UwaisBaig/AERIS-Monitor/docs/AERIS-Circuit.png

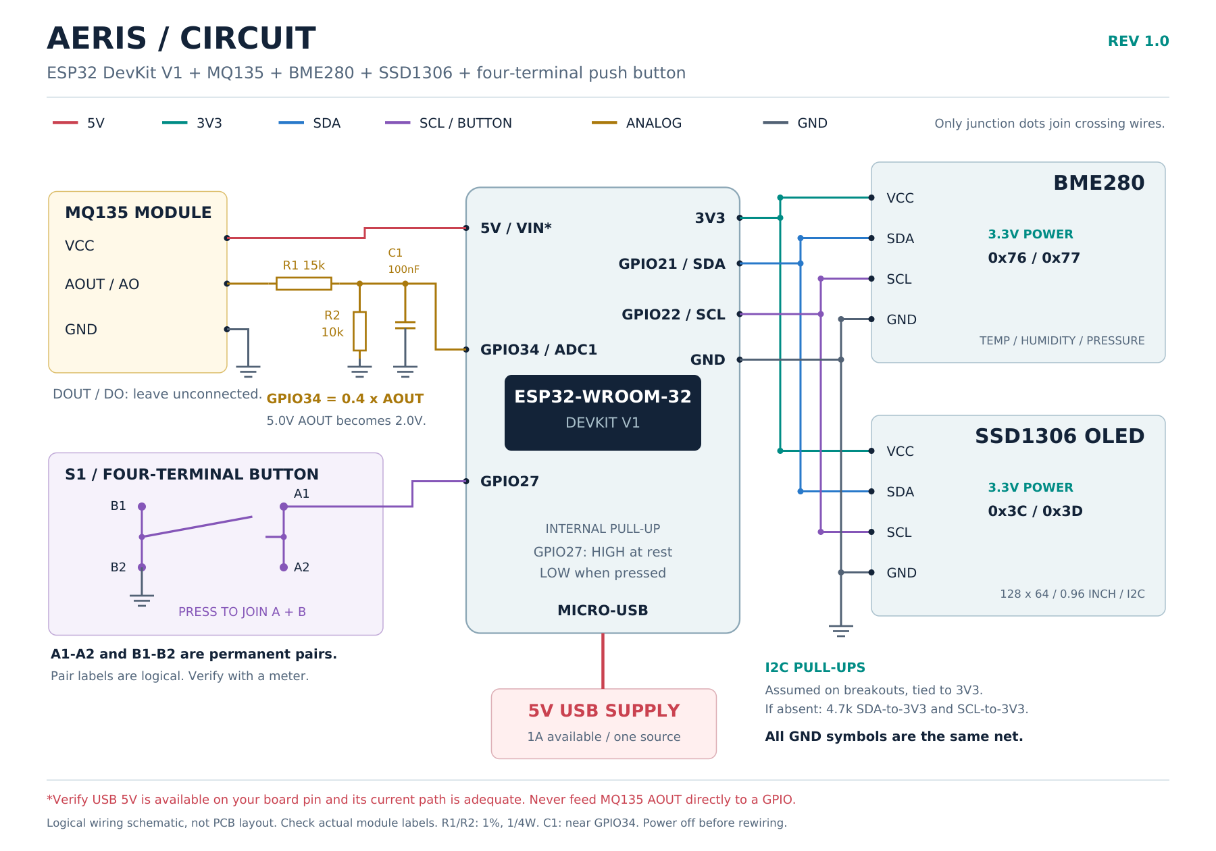
docs/AERIS-Circuit.png
