UwaisBaig/AERIS-Monitor/docs/AERIS-Dance-Preview.png

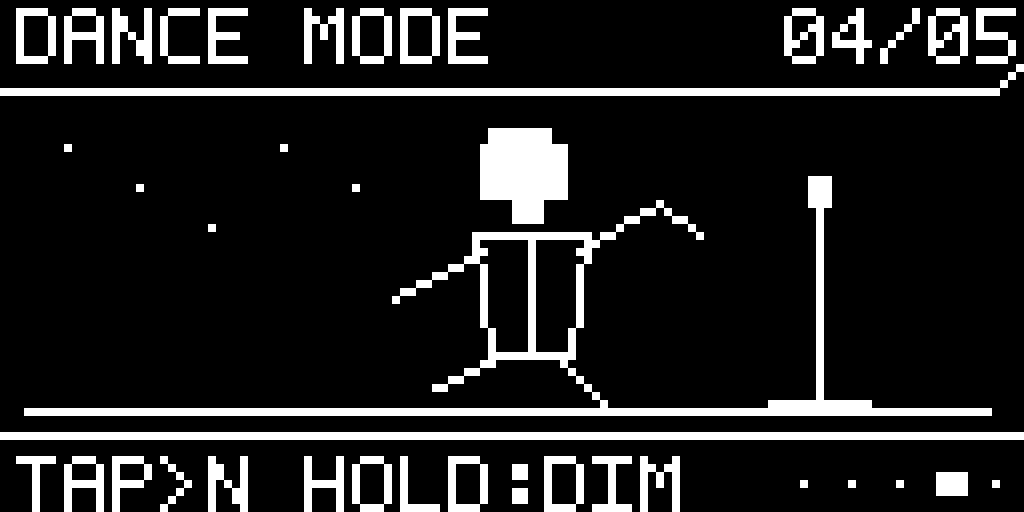
docs/AERIS-Dance-Preview.png
