UwaisBaig/AERIS-Monitor/docs/AERIS-Display-Preview.png

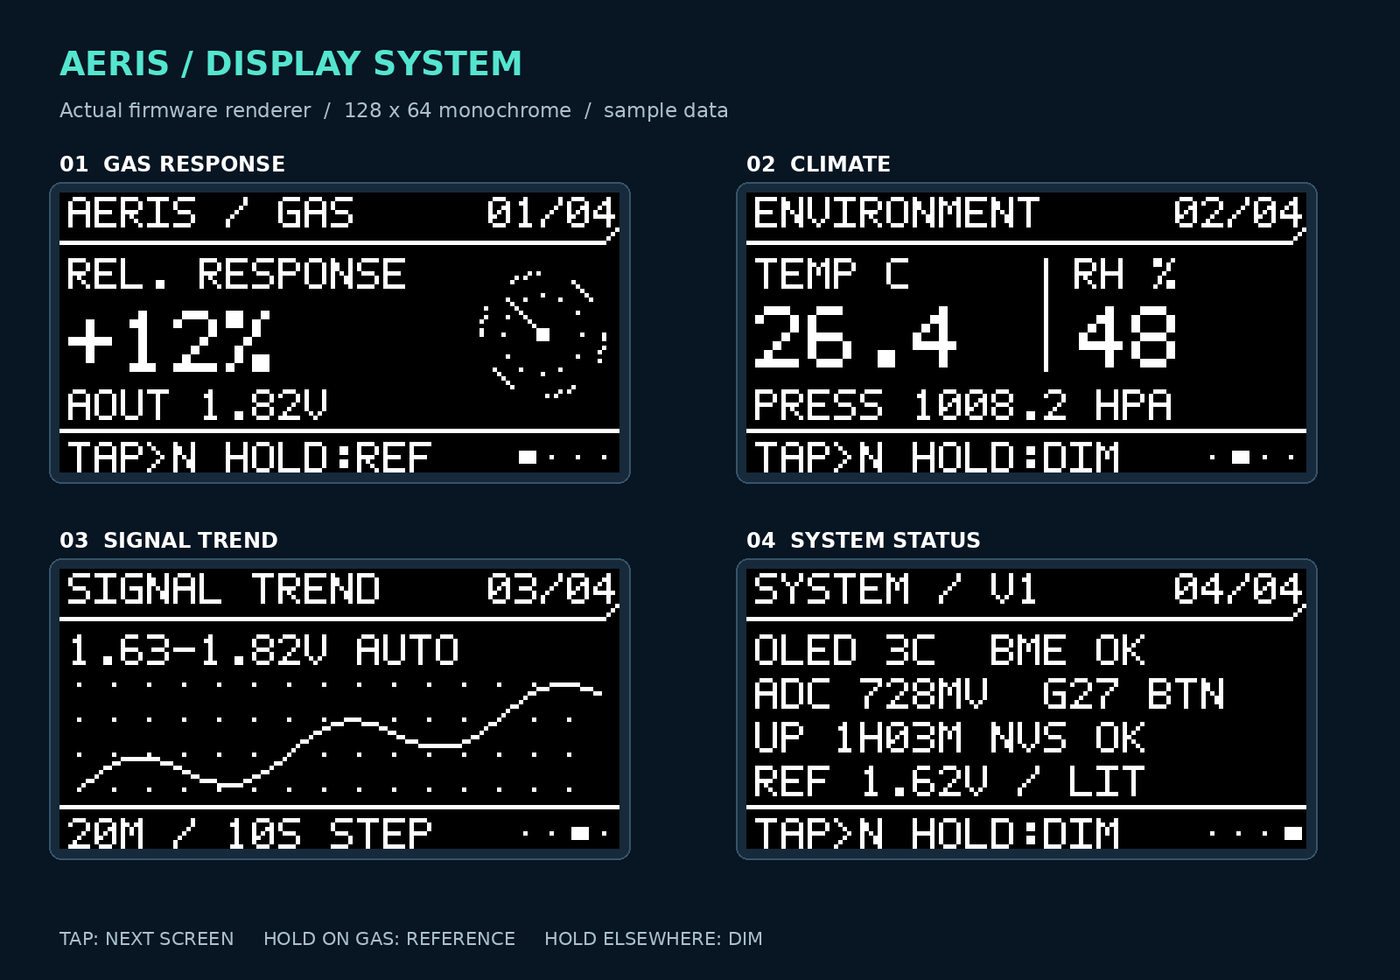
docs/AERIS-Display-Preview.png
