UwaisBaig/AERIS-Monitor/docs/screen-1.png

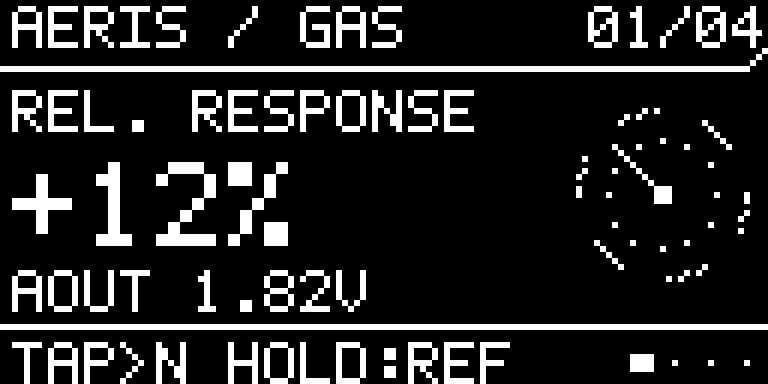
docs/screen-1.png
