UwaisBaig/AERIS-Monitor/docs/screen-2.png

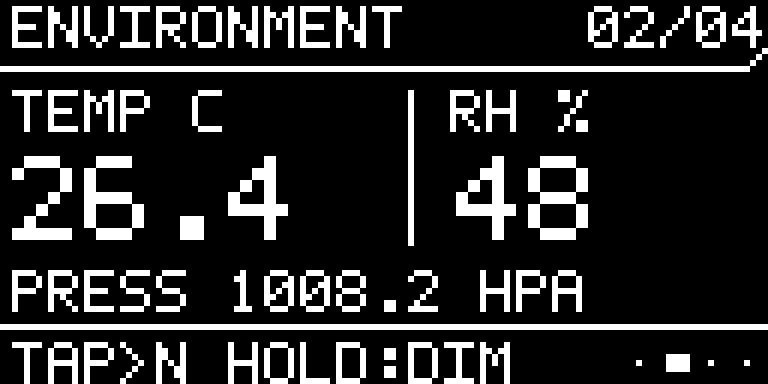
docs/screen-2.png
