UwaisBaig/AERIS-Monitor/docs/screen-3.png

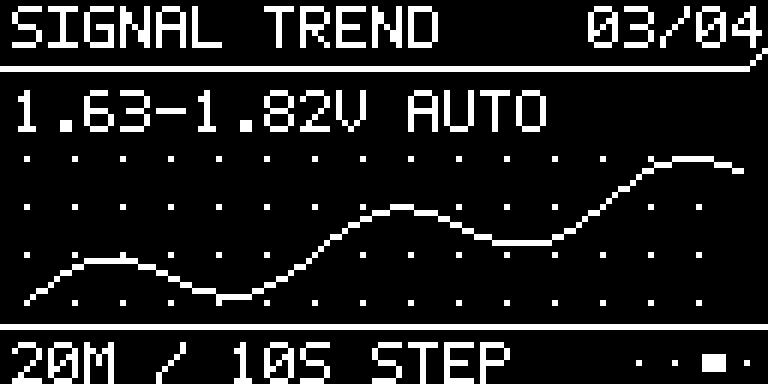
docs/screen-3.png
