UwaisBaig/AERIS-Monitor/docs/screen-4.png

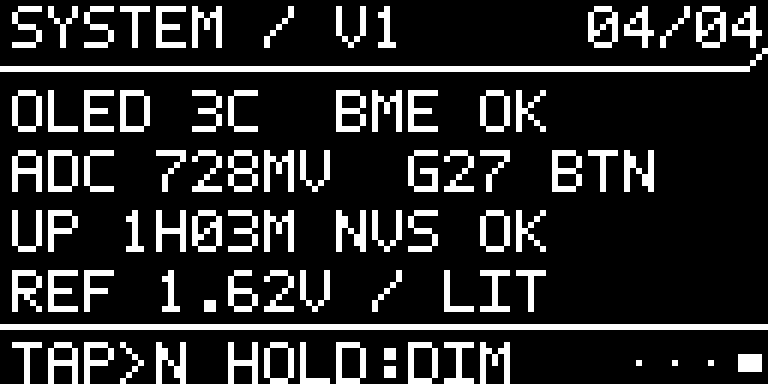
docs/screen-4.png
