UwaisBaig/AERIS-Monitor/docs/screen-reference.png

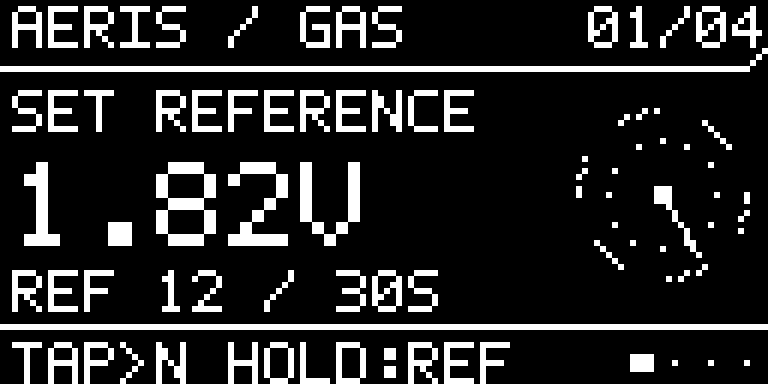
docs/screen-reference.png
