UwaisBaig/AERIS-Monitor/docs/screen-warmup.png

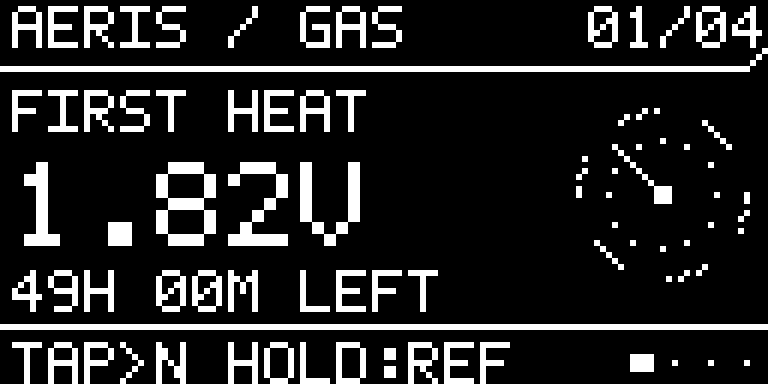
docs/screen-warmup.png
